Huster2017/Project_final/README.md

# Project_final

đây là đồ án tốt nghiệp, mặc dù rất phèn và cổ nhưng mình thích nó.
