Huster2017/Project_final/HD212-39ET_DA_BuiTrungKien/design/kien1_Project.pdf

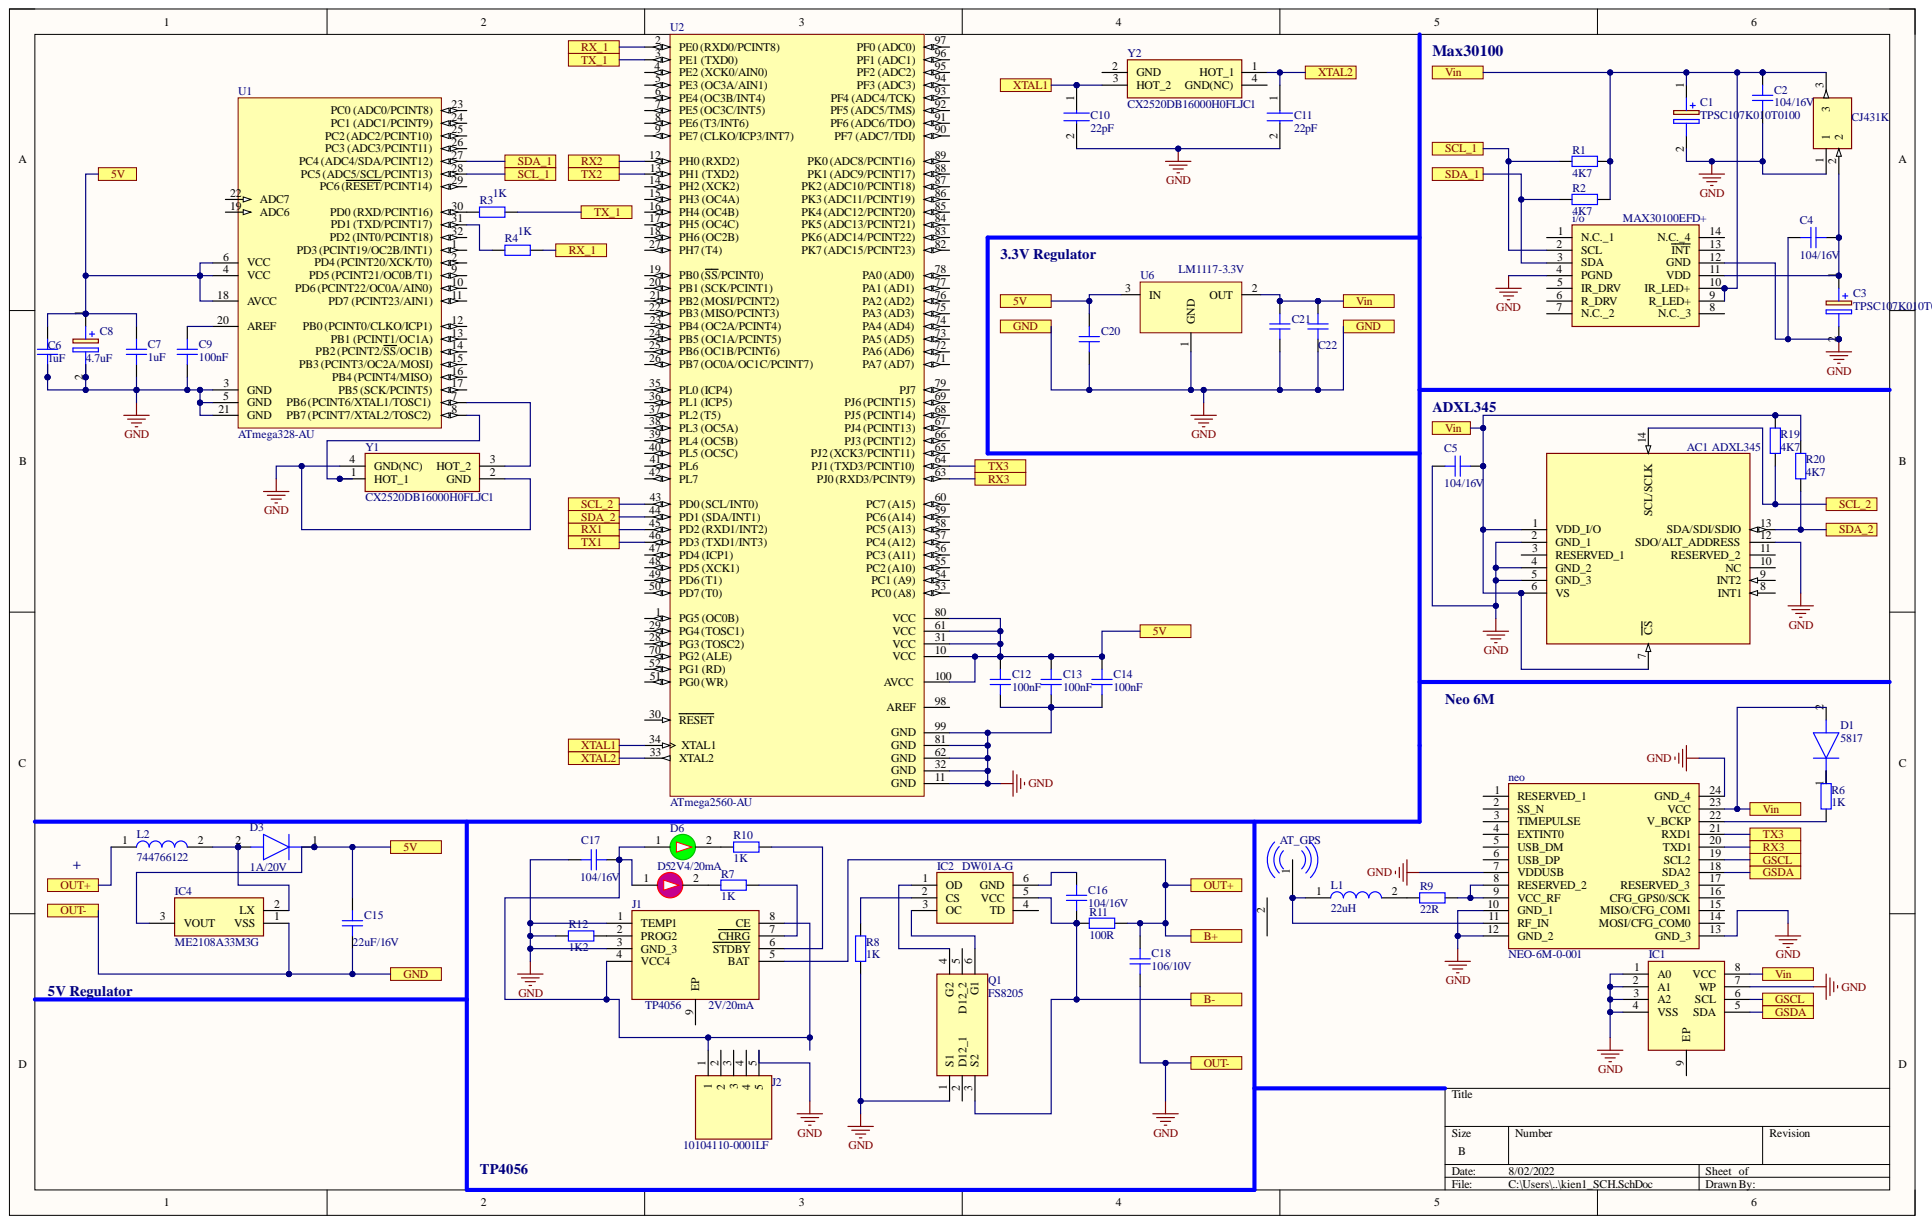
[picture p39: page 1]

U1 | | | | Y2 | Max30100

RX_1 | PE3 (OC3A/AIN1) 5 PE2 (XCK0/AIN0) 4 PE1 (TXD0) 3 PE0 (RXD0/PCINT8) 2

PG3 (TOSC2) 28 | 5V

D3 | D6 R10 | AT_GPS | EXTINT0 4

USB_DM 5 | | TX3

Title

Size B | Number | Revision

Date: 8/02/2022 | Sheet of
File: C:\Users\..\kien1_SCH.SchDoc | Drawn By:
