Huster2017/Project_final/(list of files, drawings)

Other design files:
HD212-39ET_DA_BuiTrungKien/design/kien1_SCH.SchDoc
HD212-39ET_DA_BuiTrungKien/design/kien_PCB.PcbDoc
